traviswolverton/kerbal-controller/docs/decisions.md

# Design decisions so far

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

## Sourcing (decided)
- **Digi-Key is the primary source,** through its API (`docs/tools/parts.py`): one order, live price, stock and
  parametric data (panel cutouts, ratings). It also sells SparkFun, Adafruit and PJRC items, so the Teensy, fader, driver,
  nubbin and arcade button all moved there from Adafruit, PJRC and Amazon.
- **Amazon.com exceptions:** the SaiDian joysticks (not stocked), the MX switches and buzzers already owned, the DSA keycaps,
  the matched AITRIP guarded toggles and the Waveshare OLEDs (Digi-Key's 2.42" OLEDs cost $30 to $57 each). The encoder knobs
  moved to Digi-Key. The ballast steel is bought locally (the Amazon plate listings were dead links).
- **Reel trap:** many small parts default to reels with minimums of 4,000 to 5,000. The tool prefers cut tape or bulk.

## Key bank
- **4 x 6 MX keys**, each with a state-feedback pixel (action groups, SAS mode bank, custom
  action groups).
- **Layout B, "annunciator rows":** 19.05 mm column pitch, **36 mm row pitch**, with
  one pixel in its own clear space directly above each key.
  `docs/pitch-examples.png` is the earlier 28 mm drawing and is superseded for row pitch.
- **Revised after the mockup:** at 30 mm rows and a 12 degree tilt the pixel above each key is
  hidden behind the keycap in front of it (a keycap is about 13.5 mm tall). The seat-view renders in
  `docs/mockup/renders/` show it. The fix is a **steeper centre panel (28 degrees)** plus the
  **36 mm row pitch**; the two side modules stay at 12 degrees. Needs a real-world check with the test plate.
- **Switches (owned):** Josojoou 72-piece pack of **blue clicky, 3-pin, pre-lubricated** MX-style switches
  ([Amazon listing](https://www.amazon.com/dp/B0GC33V4HK)), bought 2026-10-10. 24 are used, so 48 spare.
  3-pin means no plastic side pegs, so a plain 14 mm square cutout should work. Clicky is loud;
  fine for a desk controller. Check snap-fit on the test plate (1.5 mm plate) and measure the
  housing below the plate (about 5 mm, plus pins) against the spacer depth.
- **Keycaps (chosen):** blank 1u **DSA profile** (about 7.6 mm tall, flat top), 24 pieces, from the
  [Mechkeeb 24 pcs DSA blank PBT listing](https://www.amazon.com/Mechkeeb-Profile-Switches-Keyboard-Replacement/dp/B0BWDQ3NKK)
  (B0BWDQ3NKK, Amazon.com). Colours still to pick: group by function (SAS / navigation, action groups,
  red for STAGE). Key labels go on the panel, not on the caps. The mockup's keycap proxy
  (18 mm wide, top at 13.5 mm above the plate) already assumes DSA. When they arrive, measure the real
  height with a switch fitted and re-check pixel visibility at 28 degrees.
- **Matrix:** hand-wired diode matrix (one 1N4148 per switch), 4 rows + 6 columns.
  Adafruit NeoKey boards were considered and dropped because they are hard to find.
- **Pixels:** BTF-LIGHTING WS2812B, 5050 on 10 mm round white PCBs (100 pcs, owned).
  Colour order **GRB**. Four solder pads per board (5V, GND, DIN, DOUT).
  Roughly 65 are planned (24 keys, 4 fuel bars of 8, 9 annunciator windows), so about 35 stay spare.
- **Data line:** 74AHCT125 level shifter, a 330-470 ohm series resistor near the first pixel,
  a large capacitor across the 5 V rail, and a separate 5 V supply of at least 3 A.
  Cap brightness in firmware.

## Joysticks (locked)
- **Two SaiDian JH-D400X-R4** 4-axis industrial joysticks, 10 kOhm potentiometers, 18.79 USD each
  ([Amazon listing](https://www.amazon.com/SaiDian-4-Axis-Joystick-Potentiometer-JH-D400X-R4/dp/B08CGYGMJL)).
  It is the part most KSP controller builds use.
- **Mapping:** right stick = pitch / yaw, twist = roll (Simpit rotation).
  Left stick = translation X / Y, twist = Z (Simpit translation). No separate rockers needed.
- **Grip buttons (decided):** the thumb button on each stick.
  - **Right stick (rotation): SAS toggle.** SAS is mostly about rotation, and the SAS key's pixel still shows the real state.
  - **Left stick (translation): hold for fine control.** While held, firmware scales that stick's X, Y and twist to about 25%
    (a tunable factor), then returns to full. It is done in firmware, so it does not depend on the game. Useful for docking.
    The game's own latching precision mode stays on the PRECISION button of the switch panel.
  - Both are direct Teensy inputs (pins 5 and 9), not on the expander, so a hold responds immediately.
- **Electrical:** passive potentiometers, so power them from the Teensy's **3.3 V**, not 5 V,
  to stay inside the ADC range. Listings give +/-20 % resistance tolerance and +/-1 %
  linearity, so calibrate the centre point and ranges in firmware.
- **Solder quickly:** the listings warn that heat can burn the part.
- **Dimensions** from the seller's side-view drawing (`docs/reference/jh-d400x-r4-side-view.png`),
  my reading of it:
  - Tilt: +/-25 degrees each way. Sealed (boot) design.
  - Grip: 35 mm diameter, 42 mm tall, with the Z (twist) potentiometer inside it.
  - Fourth "axis": a **momentary button switch on top of the grip**, not an analog axis.
    Free for something like an RCS toggle or SAS hold.
  - Overall height 84 mm to the top of the grip, plus 10.5 mm for the button = 94.5 mm.
  - Body below the mounting plate: 25.5 mm deep. That leaves about 58.5 mm above the plate
    to the top of the grip (about 69 mm to the top of the button).
  - Body width 40.4 mm, 49.6 mm including the Y potentiometer bump on one side.
  - X and Y potentiometers sit on the body (Y on the side that adds 9.2 mm).
- **Still not known:** the mounting flange outline, mounting hole spacing and hole diameter
  (the drawing is a side view and does not show them) and the cutout depth in the other
  direction. **Measure the units when they arrive** before drawing the stick panels, or find a top-view drawing.
- **Clearance estimate:** at full +/-25 degree tilt the grip edge sweeps roughly 35-40 mm from
  the stick axis (estimated from the drawing scale). Keep keys and other controls at least that far
  from each stick, with margin.

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

## Switch panel and annunciator (proposed)
- **Switch panel (left strip):** all inputs that are not wired to a stick or encoder go on one panel and one
  chip, an MCP23017 I2C expander sitting right behind it: ABORT (guarded toggle), a key switch that arms STAGE, a guarded ENGAGE / DISENGAGE toggle, a big STAGE
  button, throttle FULL and CUT, MAP, focus previous and next, quicksave, quickload, precision, pause, UI hide,
  and three spares. That is 16 inputs, listed in `pin-map.md`. Only SDA, SCL, the interrupt and 3V3 cross the
  cable to the Teensy.
- **Why:** the Teensy has no spare header pins, so extra buttons need an expander. A single panel keeps its
  wiring local and frees the toggle pins. This is also the part of the reference build (Altitude Workshops) we
  were missing: its guarded LOCK/STAGE block, throttle FULL button and utility buttons.
- **Buttons:** 13 small ones are the MX switches already owned, with blank DSA caps. A second pack of 24 caps is
  needed. STAGE moves off the key matrix to the big button, so its matrix slot becomes AG9.
- **Game side:** MAP, quicksave and the rest are key presses through Simpit's keyboard emulator (Windows only).
  FULL and CUT drive the throttle, and the motorised fader follows through Simpit's throttle command message.
- **Annunciator (right strip):** 3 x 3 windows, one pixel each: low fuel, low power, overheat, low altitude,
  stable orbit, atmosphere, chute safe, link, and CONTROLS (lit while engaged). Most of these come straight from Simpit messages
  (resources, temperature limit, atmosphere conditions, altitude, orbit, flight status). Chute-safe would be derived
  from altitude and airspeed. **High G was dropped: Simpit has no G-force message.**
- **Master power switch (middle strip, guarded):** in series with the 5 V rail. It cuts the pixels and the fader driver
  but leaves the Teensy and expander powered over USB. It is a third guarded toggle from the AITRIP pack, so a bump cannot
  kill the lights.
- **Layout effect:** the right strip's freed corner holds the annunciator and the middle strip gets the master switch. The
  strips are now 245 mm wide (see the keyboard decision below).
- **STAGE key (decided):** a key switch arms STAGE. The big STAGE button only fires while the key is on, which
  replaces the second guarded toggle. The key position is an expander input, so the firmware does the interlock.
- **RESET: skipped (decided).** Recovery from a hang is replugging the USB cable.
- **ENGAGE / DISENGAGE (decided):** a guarded toggle on the switch panel, modelled on the reference build's toggle by the
  throttle. Engaged, the sticks and throttle send input; disengaged, the firmware sends zero rotation and translation
  (which leaves SAS and the game in control) and stops sending throttle, so a bump or a leaning arm does nothing.
  The annunciator's ninth window, CONTROLS, lights while engaged. Check how Simpit hands the throttle back: its
  changelog mentions throttle authority being released.
- **Skipped, decided:** the reference's two arrow buttons beside its attitude stick. Our two sticks and the
  camera encoder cover that job; revisit only if you find you want attitude trim.
- **Parts picked (all Digi-Key):**
  - STAGE key switch: E-Switch KO133A801 (EG5876-ND, $7.07), 2-position SPST, **12 mm cutout**, key removable in
    position 1 only. Confirm in the datasheet that position 1 is OFF.
  - Big STAGE button: Adafruit 3489 arcade button (1528-2316-ND, $2.50), **30 mm cutout**, red 5 V LED, 2.8 mm quick-connect.
    The LED is open: always on, or driven later.
  - Master power switch: now a guarded AITRIP toggle (see below), replacing the E-Switch ST141D00 that was picked first.
  - Expander: MCP23017-E/SP (DIP-28, $1.69) with a socket, hand-wired on perfboard behind the panel instead of a breakout
    board. A0-A2 tied to GND (address 0x20), RESET through 10 k to 3V3, 0.1 uF across its supply.
- **Open:** the expander's interrupt behaviour is untested, and the Digi-Key key switch's key position needs confirming.

## Inter-module links (proposed, five-piece layout)
- **Approach:** direct wiring from the Teensy in the middle strip piece to each of the four outer pieces
  (two wings, left and right strip) through one **DB25 D-sub** each. One USB cable, no extra boards.
  Satellite microcontrollers with a 4-wire link would need fewer wires but add firmware and a second USB
  or serial path; revisit only if the cable count becomes a problem.
- **Conductors per port:** left wing 19, right wing 14, left strip 21, right strip 16, all of 25. Full
  pinouts and the Teensy pin table are in `pin-map.md`.
- **Pixels:** one chain of 65 on a single data pin: left strip (12), fuel bars in the middle (32), right strip
  (12 key pixels and 9 annunciator pixels). A break in the chain darkens everything after it.
- **Keys:** one 4 x 6 matrix. The left strip carries rows 0-1, the right strip rows 2-3, both carry all six
  column lines.
- **Parts (Digi-Key):** four **female** DB25 panel jacks on the middle piece (ITT Cannon ZDB25S) and one **male** jack
  on each outer piece (ZDB25P), joined by four straight-through shielded female-to-male cables, 1 m (Phoenix Contact
  1656291), listed in `parts-list.md`. The cables fit only one way round. The jacks mount from inside, with the flange
  against the inner wall and the body standing 11 mm proud. The wing jack is on the wing's outer end wall; the two outer
  strips and the middle strip carry theirs on the back wall, so every cable runs outside, behind the console (about 0.6 m of
  path for a wing cable). They are 1 m for all four to keep one part number; coil the slack.
  Keep analog runs short and put 0.1 uF on each wiper.
- **Swapped-cable rule:** all four ports use the same connector, so a cable in the wrong port must be
  harmless. Ground and 5 V sit on the same pins everywhere, and everything the Teensy drives (rows, pixel
  data, fader PWM) is on pins 15-23, which any module not using them leaves open. A script check of all 16
  module and port pairs found no conflict.
- **DB25 cutout (from the ITT Cannon ZD datasheet, rear mount):** 42.52 x 11.40 mm, with two 3.05 mm mounting holes
  47.04 mm apart (modelled 3.2 mm). The flange is 53.09 mm wide.
- **DC jack and fuse holder cutouts (from the datasheets, read 2026-10-20):** the Tensility 54-00151 needs a 10.9 mm hole with
  two flats 9.8 mm apart (panel 1.5 to 4.5 mm); the Wurth fuse holder needs a 13 mm hole with a 1.8 mm key out to 14 mm
  (panel 0.8 to 2.8 mm). Both sit in the middle strip's back wall (2.4 mm), so the thickness limits are met. Datasheet values,
  not yet checked on the parts.
- **Provisional cutout (orange in the mockup, size NOT verified):** the USB micro-B extension (15 x 8 mm slot with two 2.5 mm
  holes). SparkFun's drawing gives only the 26 mm body length, no panel cutout, so measure the part.
- **Open:** cable management behind the console, and the USB extension's cutout.

## 5 V power (chosen, not yet ordered)
- **Supply:** Mean Well GST25A05-P1J (Digi-Key 1866-2087-ND, $14.30): 5 V, 4 A max, 20 W, positive centre, 2.1 x 5.5 mm plug,
  1 m lead, cULus approved. It has an IEC C14 inlet, so a mains cord is a separate part (Tensility 11-00022, NEMA 5-15 to
  C13, $4.37). This replaces the Adafruit 1466.
- **Panel connector:** Tensility 54-00151 (Digi-Key 839-54-00151-ND, $4.81): 5.5 x 2.1 mm panel jack, 7.5 A, solder cup,
  rear nut. **Its panel cutout is not verified** (the datasheet is an image), so measure the jack or read the drawing
  before cutting. This replaces the Tugermoola kit from Amazon.
  - Wire from the solder cups: the centre pin is +. Check polarity with a meter before connecting anything.
  - Keep the jack close to the fuse and 5 V rail, or extend the wires.
- **Budget:** pixels are 65 x 60 mA = 3.9 A worst case (all white, which firmware must never allow); fader motor is unknown at 5 V, measure
  it. Cap total pixel draw in firmware so real use stays well under 4 A. The usual guidance is to keep
  the rail above 4.5 V at full load and to leave 20-25 % headroom.
- **Wiring plan:**
  - The Teensy is powered **only from USB**. The external 5 V feeds the pixels, the level shifter and the
    fader driver, with ground shared with the Teensy. Do not tie the 5 V rail to the Teensy's VIN.
  - Put a fuse sized just above the capped load on the 5 V rail, and the 1000 uF capacitor where the rail
    enters the pixel run.
  - The 2.42" OLED modules accept 3.3-5 V, so power them from the 5 V rail to keep load off the Teensy's
    3.3 V regulator. Confirm the module's logic level first.
  - The pixels are spread over the three strip pieces (12, 32, 21). Each outer strip takes 5 V over its DB25 cable; one power input in the middle strip feeds everything.

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

## Mockup (v0 proposal)
See `docs/mockup/README.md`. Three modules of 220 / 240 / 220 mm width, 245 mm deep, tilted
12 / 28 / 12 degrees. All positions are a first proposal to react to.

## Open items
- Measure the real pixel board (diameter and height) with calipers.
- Print the test plate (`cad/test_plate.scad`) and settle the MX cutout tolerance and
  diffuser thickness.
- Measure the joysticks on arrival (mounting flange, hole spacing and diameter, cutout).
- Whether to include the round attitude TFT.
- Column pitch: 19.05 mm for now, 22-25 mm is an option for finger room.
- Check the 28 degree centre tilt feels right at your desk (prop the test plate at that angle).
- Firmware: key assignment map, Simpit channel list, serpentine pixel mapping.
