traviswolverton/kerbal-controller/docs/pin-map.md

# Pin map and cabling (draft, five-piece layout)

Teensy 4.1 pin assignment, the cabling between the five pieces, and the four DB25 pinouts. Matches
`cad/console_mockup_v1.scad`. **This file is generated by `docs/tools/gen_pinout.py`, the same script that draws
the diagrams in [wiring.md](wiring.md) (renders on GitHub) and [pinout.html](pinout.html) (for a browser).
Edit the data in the script, not this file.** Draft: nothing is built yet. Context is in `decisions.md` and
`parts-list.md`.

## Topology

```
                         LEFT WING                          RIGHT WING
                         stick, fader, enc                  stick, 2 enc
                              |  DB25 (19)                       |  DB25 (14)
                              |                                  |
   STRIP LEFT  --DB25 (21)--  STRIP MIDDLE  --DB25 (16)--  STRIP RIGHT
   12 nav keys                Teensy, 2 OLEDs, 32 fuel         12 action-group keys
   switch panel + expander    pixels, buzzer, master switch,   annunciator
   12 pixels                  power jack                       21 pixels
                              (5 V in, fuse, 1000 uF)
```

- The **middle strip** holds the Teensy, the 5 V input, the 74AHCT125 and the OLEDs and buzzer. It has four DB25
  jacks, one per outer piece.
- The **left strip** carries a **switch panel**: 16 inputs on one MCP23017 I2C expander that sits right behind
  the panel. The inputs wire locally, so only SDA, SCL, the interrupt and 3V3 cross the cable. The inputs are
  the guarded ABORT toggle, a key switch that arms STAGE, a big STAGE button, throttle FULL and CUT, MAP, focus
  previous and next, quicksave, quickload, precision, pause, UI hide, a guarded ENGAGE / DISENGAGE toggle and two spares.
- The **right strip** carries a 3 x 3 **annunciator**: one pixel behind each of nine windows.
- The two **wings** sit in front of the outer strip pieces, so their jacks are on the wings' outer end walls. The
  strip pieces and the middle strip have their jacks on their back walls. Every cable runs outside, behind the console
  (the middle strip has the four female jacks in two rows). About 0.6 m of path for a wing cable, so a 1 m cable has slack.
- **Pixels are one chain of 65** on a single data pin: left strip (12 key pixels), then the 32 fuel bars in the
  middle, then the right strip (12 key pixels and 9 annunciator pixels). The data goes out to the left strip on
  pin 17, comes back on pin 18, runs through the fuel bars, and leaves for the right strip on pin 17 of that
  port. Put the 330-470 ohm series resistor at the first pixel (in the left strip). If a strip cable is
  unplugged, every pixel after it goes dark.
- **Keys are one 4 x 6 matrix** split across the strips: the left strip carries rows 0-1 and the right
  strip rows 2-3. Both carry all six column lines, which are paralleled in the middle piece. STAGE is no longer
  a matrix key: its slot is AG9.

## Constraints that shaped it

- All 3.3 V, none of the pins are 5 V tolerant. Analog inputs must stay at or below 3.3 V.
- Only header pins 0-41 are used. Pins 42 and up are bottom pads.
- **Pin 1** is the pixel data output: Serial1 TX, supported by the WS2812Serial library (non-blocking, DMA).
  It goes to the 74AHCT125 level shifter.
- **Pins 2 and 3** are the fader PWM pair: both are on timer FlexPWM4.2, so they share one frequency
  (default 4.482 kHz, changeable with `analogWriteFrequency`).
- **Pins 18 and 19** are the Teensy's I2C pins (SDA, SCL), used for the switch-panel expander. Fit 4.7 kΩ
  pull-ups to 3V3 at the Teensy end.
- **Pin 13** has the on-board LED and is the SPI clock for the OLEDs. **Pin 12** is MISO on SPI0 but is a
  plain GPIO here (OLED DC), because the OLEDs are write-only.
- Analog inputs are pins 14-27 and 38-41; the seven used are 14-17 and 20-22.
- The 3.3 V regulator is good for about 250 mA external. The pots and the expander draw almost nothing.
- The matrix is read by driving a row low and reading the columns with pull-ups. **Leave the other rows
  as inputs (high impedance), never driven high**, so a stray short cannot fight a driven pin.

## Teensy 4.1 assignment

| Pin | Signal | Direction | Piece |
|---|---|---|---|
| 0 | OLED_RES | out | middle strip |
| 1 | PIXEL_DATA | out | middle strip |
| 2 | FADER_PWM_A | out | left wing |
| 3 | FADER_PWM_B | out | left wing |
| 4 | FADER_TOUCH | in (FastTouch) | left wing |
| 5 | L_STICK_BTN | in, pull-up | left wing |
| 6 | L_ENC_A | in, pull-up | left wing |
| 7 | L_ENC_B | in, pull-up | left wing |
| 8 | L_ENC_SW | in, pull-up | left wing |
| 9 | R_STICK_BTN | in, pull-up | right wing |
| 10 | OLED_CS1 | out | middle strip |
| 11 | OLED_MOSI | out | middle strip |
| 12 | OLED_DC | out | middle strip |
| 13 | OLED_SCK | out | middle strip |
| 14 (A0) | L_STICK_X | analog | left wing |
| 15 (A1) | L_STICK_Y | analog | left wing |
| 16 (A2) | L_STICK_Z | analog | left wing |
| 17 (A3) | FADER_WIPER | analog | left wing |
| 18 | EXP_SDA | I2C, 4.7 kΩ pull-up to 3V3 | left strip, switch panel expander |
| 19 | EXP_SCL | I2C, 4.7 kΩ pull-up to 3V3 | left strip, switch panel expander |
| 20 (A6) | R_STICK_X | analog | right wing |
| 21 (A7) | R_STICK_Y | analog | right wing |
| 22 (A8) | R_STICK_Z | analog | right wing |
| 23 | R_CAM_SW | in, pull-up | right wing |
| 24 | OLED_CS2 | out | middle strip |
| 25 | BUZZER | out | middle strip |
| 26 | R_CAM_A | in, pull-up | right wing |
| 27 | R_CAM_B | in, pull-up | right wing |
| 28 | ROW0 | out | left strip |
| 29 | ROW1 | out | left strip |
| 30 | ROW2 | out | right strip |
| 31 | ROW3 | out | right strip |
| 32 | COL0 | in, pull-up | both strips |
| 33 | COL1 | in, pull-up | both strips |
| 34 | COL2 | in, pull-up | both strips |
| 35 | COL3 | in, pull-up | both strips |
| 36 | COL4 | in, pull-up | both strips |
| 37 | COL5 | in, pull-up | both strips |
| 38 | R_PAGE_A | in, pull-up | right wing |
| 39 | R_PAGE_B | in, pull-up | right wing |
| 40 | R_PAGE_SW | in, pull-up | right wing |
| 41 | EXP_INT | in, pull-up | left strip, switch panel expander |

All 42 header pins are used. Any further switch goes on the expander (16 inputs, all assigned including 3
spares) or a second MCP23017 at another address.

## Switch-panel expander

MCP23017-E/SP (DIP-28), hand-wired on perfboard behind the panel. Address pins A0-A2 tied to GND (address 0x20), RESET
through 10 kΩ to 3V3, 0.1 uF across its supply. Mirror both interrupt ports onto INTA. Internal pull-ups on, the other
leg of every switch to GND.

| Expander pin | Input |
|---|---|
| PA0 | ABORT (guarded toggle) |
| PA1 | STAGE KEY (key switch: STAGE only works while it is on) |
| PA2 | STAGE (big button) |
| PA3 | THROTTLE FULL |
| PA4 | THROTTLE CUT |
| PA5 | MAP |
| PA6 | FOCUS PREVIOUS |
| PA7 | FOCUS NEXT |
| PB0 | QUICKSAVE |
| PB1 | QUICKLOAD |
| PB2 | PRECISION |
| PB3 | PAUSE |
| PB4 | UI HIDE |
| PB5 | ENGAGE / DISENGAGE (guarded toggle: sticks and throttle live or ignored) |
| PB6-PB7 | spare |

MAP, quicksave, quickload and the rest go to the game as key presses through Simpit's keyboard emulator
(Windows only). FULL and CUT drive the throttle, and the motorised fader follows through the throttle command
Simpit sends back. ENGAGE / DISENGAGE is a controls-live interlock: disengaged, the firmware sends zero rotation and
translation (so SAS and the game keep control) and stops sending throttle; the annunciator's CONTROLS window lights
while engaged. Check how Simpit hands the throttle back (its changelog mentions throttle authority being released).

## DB25 pinouts

Standard DB25 numbering, pins 1-13 on the wide row and 14-25 on the other. The outer pieces have male jacks and the
middle strip female jacks, joined by female-to-male cables, but all four middle jacks are alike, so a cable can still go
in the wrong middle port. The pins are laid out so that is **harmless**:

- Ground is on pins 1, 7, 13, 24, 25 on every port.
- 3.3 V (pin 2) is provided on the two wing ports and the left-strip port. 5 V (pins 20, 21) is provided on the
  left-wing and both strip ports.
- Everything the Teensy **drives** sits on pins 15-23 only: matrix rows and pixel data on pins 15-17 of the
  strip ports, fader PWM on pins 22 and 23 of the left-wing port. Pins that are not used by a module are left
  open, never wired to something else. So a module never connects a switch, a wiper or a ground to a pin the
  Teensy drives.
- SDA and SCL (pins 10 and 11 of the left-strip port) are weak pulled-up open-drain lines, so a switch pulling
  them low on another cable only upsets the bus, it cannot damage anything.
- A script check (all 16 combinations of module and port) found no conflict, only wrong behaviour.

| Pin | Left Wing | Right Wing | Strip Left | Strip Right |
|---|---|---|---|---|
| 1 | GND | GND | GND | GND |
| 2 | 3V3 | 3V3 | 3V3 | open |
| 3 | L_STICK_X | R_STICK_X | COL0 | COL0 |
| 4 | L_STICK_Y | R_STICK_Y | COL1 | COL1 |
| 5 | L_STICK_Z | R_STICK_Z | COL2 | COL2 |
| 6 | FADER_WIPER | open | COL3 | COL3 |
| 7 | GND | GND | GND | GND |
| 8 | L_STICK_BTN | R_STICK_BTN | COL4 | COL4 |
| 9 | L_ENC_A | R_CAM_A | COL5 | COL5 |
| 10 | L_ENC_B | R_CAM_B | EXP_SDA | open |
| 11 | L_ENC_SW | R_CAM_SW | EXP_SCL | open |
| 12 | FADER_TOUCH | R_PAGE_A | EXP_INT | open |
| 13 | GND | GND | GND | GND |
| 14 | open | R_PAGE_B | open | open |
| 15 | open | open | ROW0 | ROW2 |
| 16 | open | open | ROW1 | ROW3 |
| 17 | open | open | PIXEL_IN | PIXEL_IN |
| 18 | open | open | PIXEL_OUT | open |
| 19 | open | R_PAGE_SW | open | open |
| 20 | 5V | open | 5V | 5V |
| 21 | 5V | open | 5V | 5V |
| 22 | FADER_PWM_A | open | open | open |
| 23 | FADER_PWM_B | open | open | open |
| 24 | GND | open | GND | GND |
| 25 | GND | open | GND | GND |
| **Conductors** | 19 | 14 | 21 | 16 |

Notes:
- Analog lines (stick X, Y, twist and the fader wiper) sit between ground pins so they are not neighbours of
  digital lines. Put a 0.1 uF capacitor from each wiper to ground at the Teensy end.
- **Cable shield:** ground it to the connector shell at the middle end only, to avoid a ground loop.
- **Pixel power:** each strip piece takes 5 V on pins 20 and 21 (two conductors, up to about 1.3 A worst case
  for 21 pixels on the right strip). The 32 fuel-bar pixels are in the middle piece and are fed straight from the
  5 V rail. A 100 uF capacitor across 5 V in each strip piece is optional.
- **Left wing:** the L9110H fader driver is in the wing next to the motor, so only the two PWM lines and 5 V
  cross the cable. Pots take 3V3 on pin 2, never 5 V.
- **Cables:** a wing cable runs from the wing's end wall round the back to the middle strip, about 0.6 m of path. The
  strip-to-middle cables are about 0.3 m. All four are 1 m, so coil the slack. Keep analog and I2C runs short.

## Open

- **Cable management** behind the console (clips or a cable channel, strain relief): not designed.
- **I2C over the cable:** about 30 cm at 400 kHz with 4.7 kΩ pull-ups should be fine; not tested.
- **OLED modules:** confirm their logic level and supply. They accept 3.3-5 V, so power them from 5 V, but
  check the SPI lines are 3.3 V safe in that case. Not verified.
- **Pixel chain through cables:** a break in the chain (an unplugged strip cable) kills the pixels after it.
  Fine for a build, worth knowing when debugging.
- **HIGH G** annunciator window dropped: Simpit has no G-force message.
- **Confirm the physical Teensy pin positions** before wiring: this map uses pin numbers only.
- **DB25 jack cutouts** are not in the mockup yet.
