traviswolverton/kerbal-controller/docs/mockup/templates/center-panel-template-1to1.pdf

## This site can’t be reached

The webpage at file://../docs/mockup/templates/center.html might be temporarily down or it may have moved permanently to a new web address.

ERR_INVALID_URL
