traviswolverton/kerbal-controller/docs/img/seat-view.png

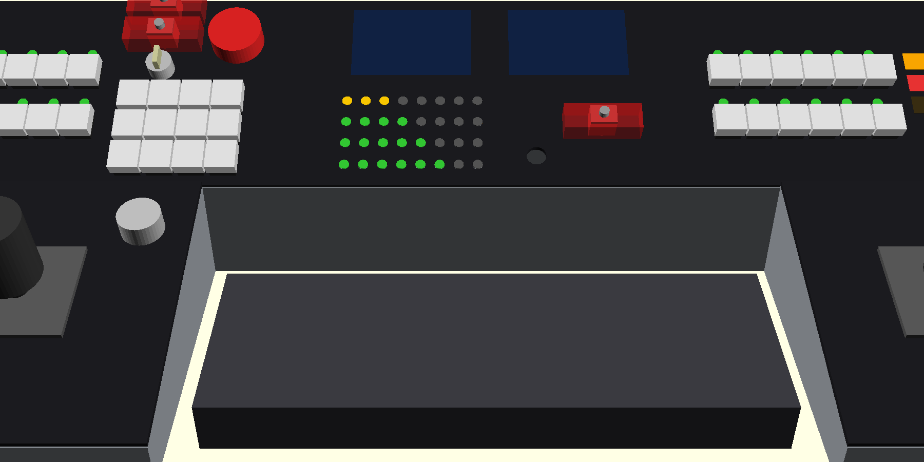
docs/img/seat-view.png
