traviswolverton/kerbal-controller/docs/mockup/renders/console-front.png

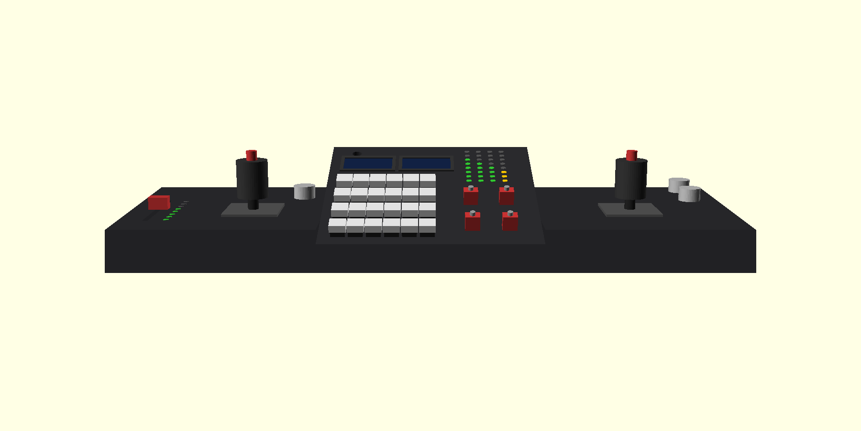
docs/mockup/renders/console-front.png
