traviswolverton/kerbal-controller/docs/mockup/renders/console-iso.png

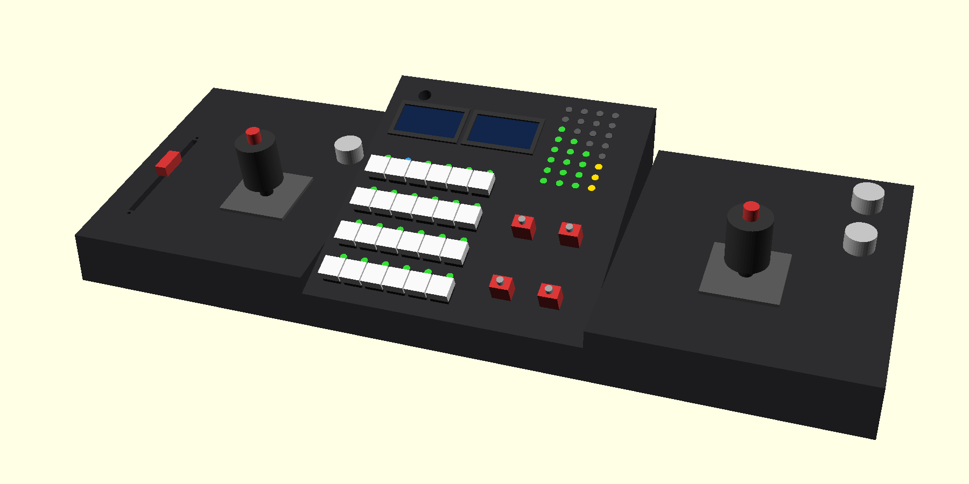
docs/mockup/renders/console-iso.png
