traviswolverton/kerbal-controller/docs/mockup/renders/console-side-center.png

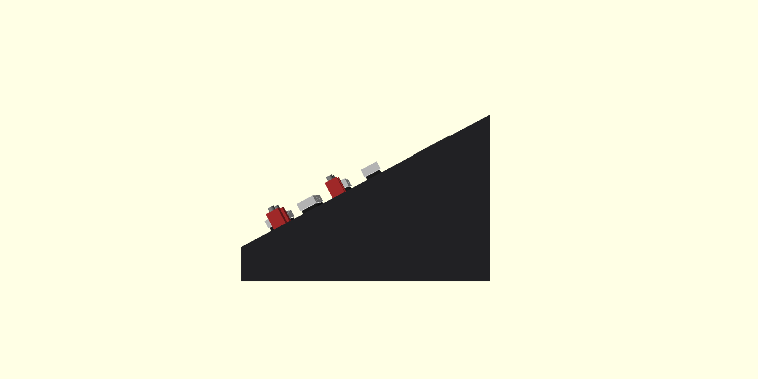
docs/mockup/renders/console-side-center.png
