traviswolverton/kerbal-controller/docs/mockup/renders/console-top.png

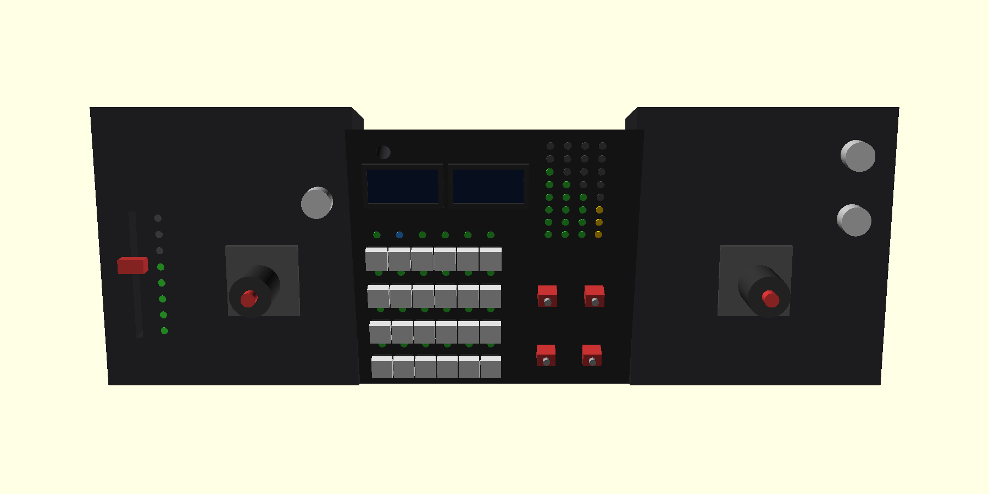
docs/mockup/renders/console-top.png
