traviswolverton/kerbal-controller/docs/mockup/renders/seat-view-center-tilt12.png

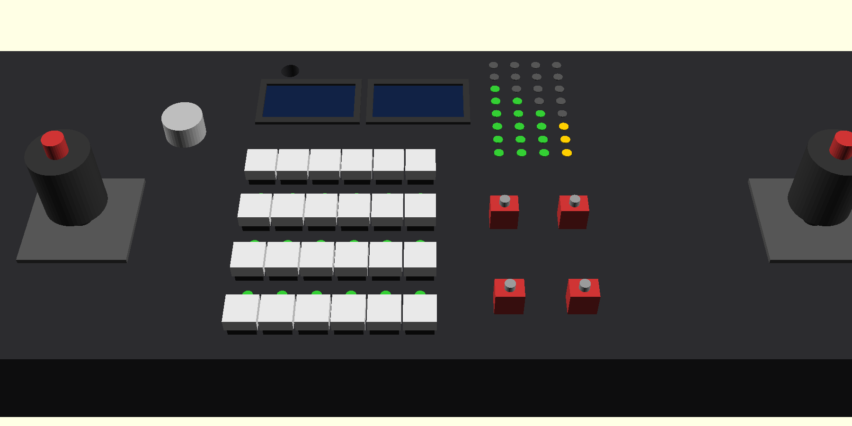
docs/mockup/renders/seat-view-center-tilt12.png
