traviswolverton/kerbal-controller/docs/mockup/renders/seat-view.png

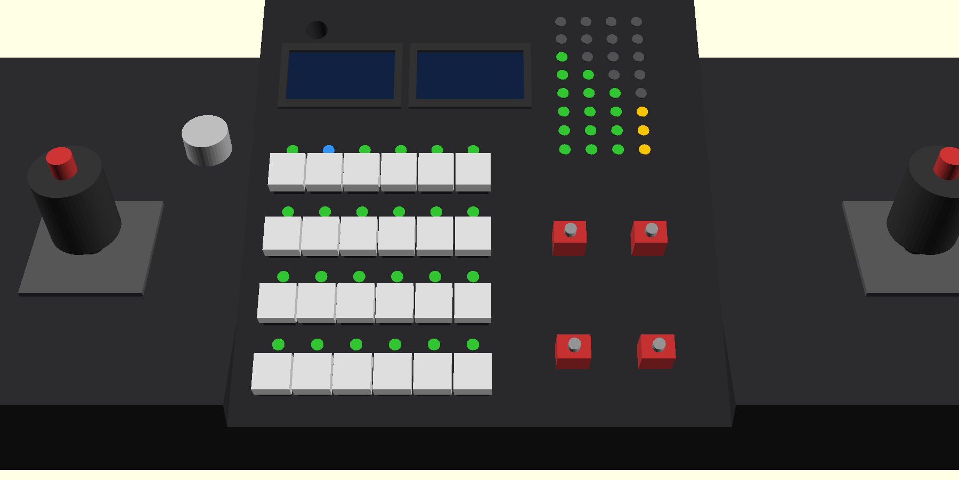
docs/mockup/renders/seat-view.png
