traviswolverton/kerbal-controller/docs/mockup/renders/v1-strip-cutaway.png

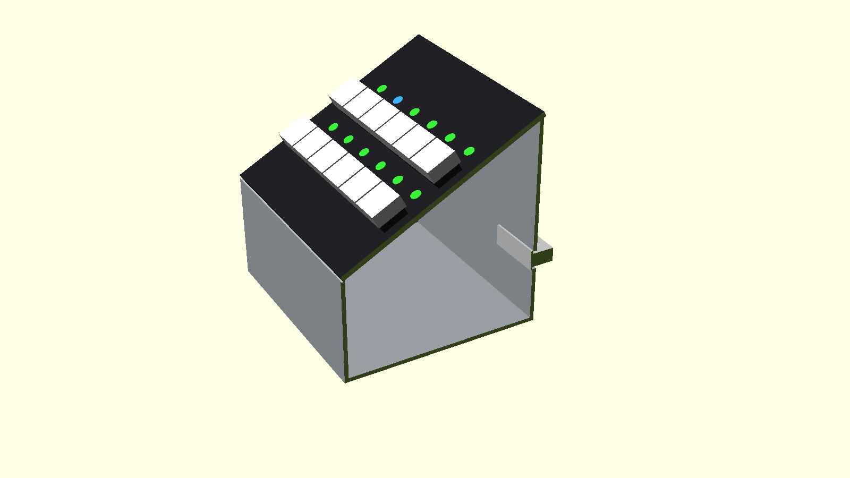
docs/mockup/renders/v1-strip-cutaway.png
