traviswolverton/kerbal-controller/docs/mockup/v1/renders/v1-iso.png

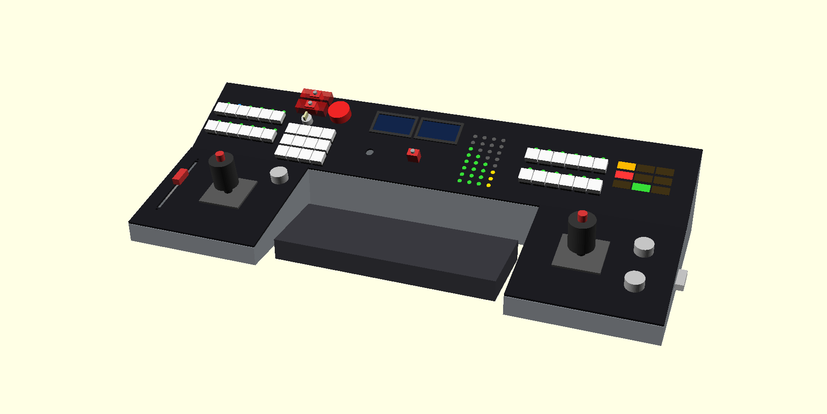
docs/mockup/v1/renders/v1-iso.png
