traviswolverton/kerbal-controller/docs/mockup/v1/renders/v1-rear.png

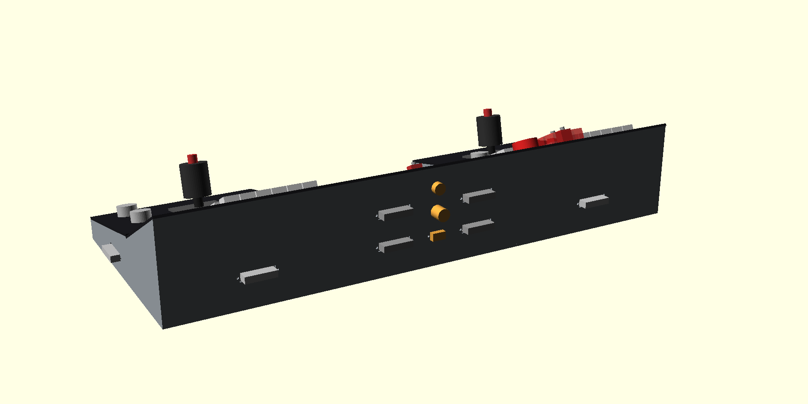
docs/mockup/v1/renders/v1-rear.png
