traviswolverton/kerbal-controller/docs/mockup/v1/renders/v1-seat-view.png

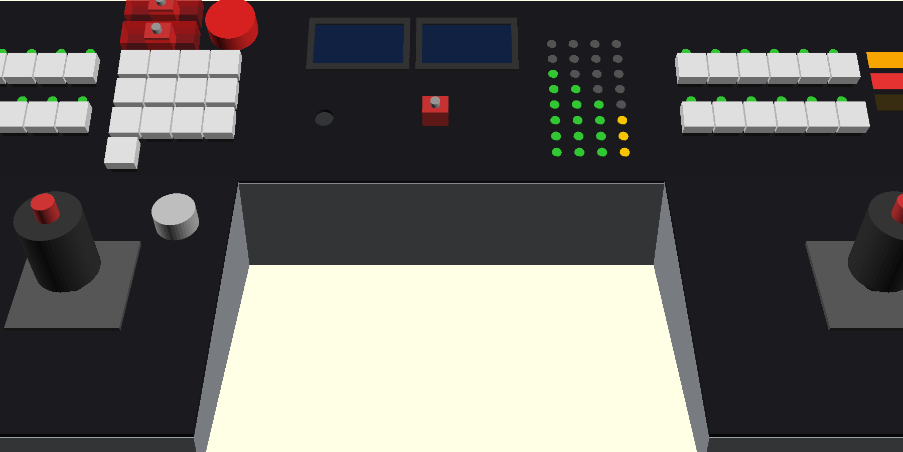
docs/mockup/v1/renders/v1-seat-view.png
