traviswolverton/kerbal-controller/docs/mockup/v1/renders/v1-top.png

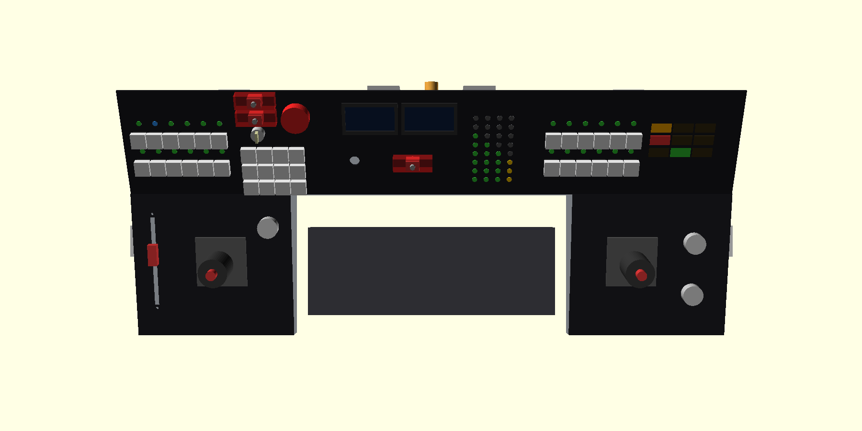
docs/mockup/v1/renders/v1-top.png
