traviswolverton/kerbal-controller/docs/pitch-examples.png

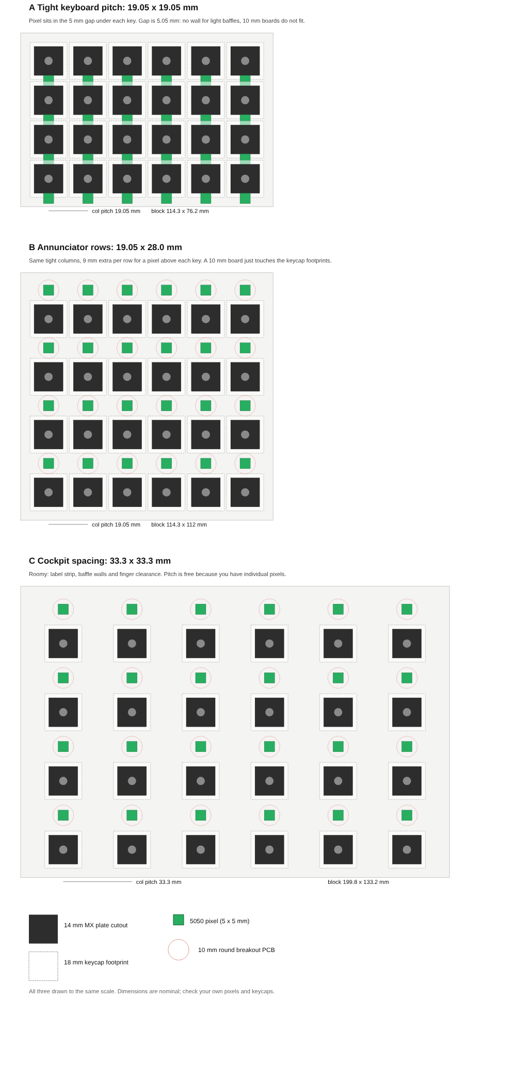
docs/pitch-examples.png
