traviswolverton/kerbal-controller/docs/reference/jh-d400x-r4-side-view.png

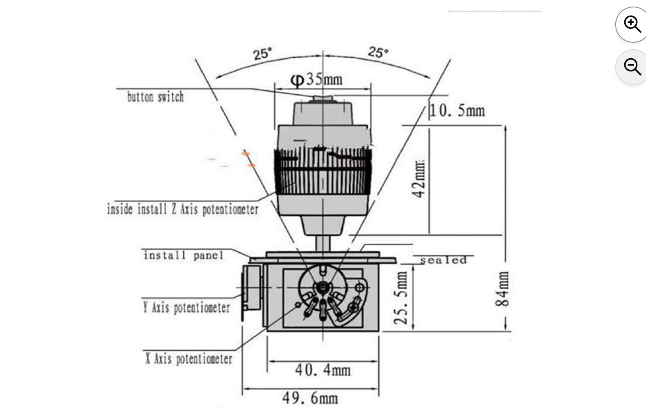
docs/reference/jh-d400x-r4-side-view.png
