traviswolverton/kerbal-controller/hardware/sourcing/budget.md

# Budget

Combined order totals, USD, **before shipping and tax**. Digi-Key and Mouser prices come from the shortlist (`hardware/sourcing/parts-shortlist.json`, last checked 2026-10-20); Amazon prices are kept by hand in `hardware/sourcing/amazon-items.json` because Amazon has no price API. Regenerate with `python3 tools/parts.py budget --md` (add `--live` to re-check the distributor prices first).

| | Lines | Amount |
|---|---|---|
| Digi-Key and Mouser | 36 | $370.39 |
| Amazon.com, priced | 4 | $117.53 |
| Amazon.com, **no price yet** | 0 | not counted |
| **Total so far** | | **$487.92** |

## Amazon.com to buy

| Item | ASIN | Qty | Unit | Extended | Note |
|---|---|---|---|---|---|
| JH-D400X-R4 joystick (SaiDian) | B08CGYGMJL | 2 | $18.79 | $37.58 | Price from the listing when chosen. |
| DSA blank keycaps, 1u, 24-pack (Mechkeeb) | B0BWDQ3NKK | 2 | $8.99 | $17.98 | Two packs for 37 caps. Colours to pick. |
| Guarded toggle switches with covers, 6-pack (AITRIP) | B0CL4GNMJX | 1 | $9.99 | $9.99 | ABORT, ENGAGE / DISENGAGE and the master power switch. Check the photos show a bat-handle toggle. |
| Weight vest steel plates, 8-pack (Mavee, silver electroplated) | unknown | 2 | $25.99 | $51.98 | Ballast: 8 plates per wing (16 in all, 2 packs, about 3.2 kg); the pocket takes 12 per wing if a third pack is needed. Link: https://a.co/d/0axItt4q (short link, ASIN not resolved). 5.9 x 0.98 x 0.28 in, 0.44 lb each. |

## Already owned

Not in the total. Prices are the listing price seen, not necessarily what was paid.

| Item | ASIN | Qty | Listing price | Note |
|---|---|---|---|---|
| MX-style blue clicky switches, 72-pack (Josojoou) | B0GC33V4HK | 1 | $12.99 | Bought 2026-10-10. 37 used. |
| Passive buzzer module, 5-pack (DIYables) | B0DHGP95K4 | 1 | $6.99 | Ordered 2026-10-10. |
| WS2812B 10 mm pixel boards, 100 (BTF-LIGHTING) | unknown | 1 | unknown | 65 used. |

## Digi-Key and Mouser

See [parts-bom.md](parts-bom.md) for the per-line list with stock and flags.

| Role | Source | Part number | Qty | Unit | Extended |
|---|---|---|---|---|---|
| Teensy 4.1 (headers fitted) | digikey | [1568-20360-ND](https://www.digikey.com/en/products/detail/sparkfun-electronics/20360/16688096) | 1 | $33.60 | $33.60 |
| 5 V 4 A desktop adapter (Mean Well GST25A05-P1J) | digikey | [1866-2087-ND](https://www.digikey.com/en/products/detail/mean-well-usa-inc/GST25A05-P1J/7703645) | 1 | $14.30 | $14.30 |
| Mains cord NEMA 5-15 to IEC C13 for the adapter | digikey | [839-11-00022-ND](https://www.digikey.com/en/products/detail/tensility/11-00022/3900584) | 1 | $4.37 | $4.37 |
| Panel DC jack 5.5 x 2.1 mm | digikey | [839-54-00151-ND](https://www.digikey.com/en/products/detail/tensility/54-00151/9829987) | 1 | $4.81 | $4.81 |
| Panel fuse holder 5 x 20 mm | digikey | [732-952005000010000-ND](https://www.digikey.com/en/products/detail/w%C3%BCrth-elektronik/952005000010000/28172649) | 1 | $2.15 | $2.15 |
| 4 A fuse 5 x 20 mm (1 spare) | digikey | [F1724-ND](https://www.digikey.com/en/products/detail/littelfuse-inc/0217004-MXP/777547) | 2 | $0.57 | $1.14 |
| STAGE key switch (12 mm cutout) | digikey | [EG5876-ND](https://www.digikey.com/en/products/detail/e-switch/KO133A801/1804779) | 1 | $7.07 | $7.07 |
| Big STAGE button, 30 mm arcade, red LED | digikey | [1528-2316-ND](https://www.digikey.com/en/products/detail/adafruit-industries-llc/3489/7349495) | 1 | $2.50 | $2.50 |
| Motorised 100 mm fader (Adafruit 5466) | digikey | [1528-5466-ND](https://www.digikey.com/en/products/detail/adafruit-industries-llc/5466/16645060) | 1 | $24.95 | $24.95 |
| L9110H fader driver | digikey | [1528-4489-ND](https://www.digikey.com/en/products/detail/adafruit-industries-llc/4489/11594498) | 1 | $1.50 | $1.50 |
| Conductive nubbin for the fader | digikey | [1528-5741-ND](https://www.digikey.com/en/products/detail/adafruit-industries-llc/5741/20370638) | 1 | $6.19 | $6.19 |
| Rotary encoders (time warp, camera, page) | digikey | [PEC11R-4215F-S0024-ND](https://www.digikey.com/en/products/detail/bourns-inc/PEC11R-4215F-S0024/4499665) | 3 | $2.95 | $8.85 |
| I2C expander for the switch panel | digikey | [MCP23017-E/SP-ND](https://www.digikey.com/en/products/detail/microchip-technology/MCP23017-E-SP/894272) | 1 | $1.69 | $1.69 |
| DIP-28 socket for the expander | digikey | [1175-1490-ND](https://www.digikey.com/en/products/detail/cnc-tech/245-28-1-06/3441586) | 1 | $1.29 | $1.29 |
| 74AHCT125 level shifter, DIP | digikey | [296-4655-5-ND](https://www.digikey.com/en/products/detail/texas-instruments/SN74AHCT125N/375798) | 1 | $1.00 | $1.00 |
| DIP-14 socket for the level shifter | digikey | [1175-1487-ND](https://www.digikey.com/en/products/detail/cnc-tech/245-14-1-03/3441580) | 1 | $0.73 | $0.73 |
| Matrix diodes (24 plus spares) | digikey | [1N4148FS-ND](https://www.digikey.com/en/products/detail/onsemi/1N4148/458603) | 30 | $0.06 | $1.80 |
| 330 ohm pixel data resistor (1 spare) | digikey | [CF14JT330RCT-ND](https://www.digikey.com/en/products/detail/stackpole-electronics-inc/CF14JT330R/1741399) | 2 | $0.10 | $0.20 |
| 4.7 kohm I2C pull-ups (spares) | digikey | [CF14JT4K70CT-ND](https://www.digikey.com/en/products/detail/stackpole-electronics-inc/CF14JT4K70/1741428) | 3 | $0.10 | $0.30 |
| 10 kohm expander reset pull-up (spares) | digikey | [CF14JT10K0CT-ND](https://www.digikey.com/en/products/detail/stackpole-electronics-inc/CF14JT10K0/1741265) | 3 | $0.10 | $0.30 |
| 1000 uF 16 V rail capacitor (1 spare) | digikey | [1189-1147-ND](https://www.digikey.com/en/products/detail/rubycon/16ZLH1000MEFC10X16/3134105) | 2 | $0.71 | $1.42 |
| 47 uF 25 V fader driver capacitor (1 spare) | digikey | [732-8823-1-ND](https://www.digikey.com/en/products/detail/w%C3%BCrth-elektronik/860020472006/5727060) | 2 | $0.10 | $0.20 |
| 0.1 uF decoupling and wiper capacitors | digikey | [BC1101CT-ND](https://www.digikey.com/en/products/detail/vishay-beyschlag-draloric-bc-components/K104K15X7RF5TH5/286555) | 12 | $0.17 | $2.04 |
| DB25 female panel jack (middle strip) | digikey | [1003-ZDB25S-ND](https://www.digikey.com/en/products/detail/itt-cannon-llc/ZDB25S/21361496) | 4 | $3.99 | $15.96 |
| DB25 male panel jack (outer pieces) | digikey | [1003-ZDB25P-ND](https://www.digikey.com/en/products/detail/itt-cannon-llc/ZDB25P/21361449) | 4 | $3.42 | $13.68 |
| DB25 shielded cable, female to male, 1 m | digikey | [277-12299-ND](https://www.digikey.com/en/products/detail/phoenix-contact/1656291/4449846) | 4 | $15.70 | $62.80 |
| Panel USB micro-B extension for the Teensy | digikey | [1568-15464-ND](https://www.digikey.com/en/products/detail/sparkfun-electronics/15464/10440474) | 1 | $4.42 | $4.42 |
| Perfboard 94 x 63 mm (middle strip main board) | digikey | [1568-12070-ND](https://www.digikey.com/en/products/detail/sparkfun-electronics/12070/5230951) | 1 | $8.65 | $8.65 |
| Screw terminal 5.08 mm, 2 position | digikey | [ED2609-ND](https://www.digikey.com/en/products/detail/on-shore-technology-inc/OSTTC022162/614558) | 6 | $0.58 | $3.48 |
| Screw terminal 5.08 mm, 4 position | digikey | [ED2611-ND](https://www.digikey.com/en/products/detail/on-shore-technology-inc/OSTTC042162/614560) | 8 | $1.08 | $8.64 |
| Female header 24 position (Teensy sockets, spare) | digikey | [S7022-ND](https://www.digikey.com/en/products/detail/sullins-connector-solutions/PPTC241LFBN-RC/810162) | 3 | $1.34 | $4.02 |
| Hookup wire 22 AWG stranded, 10 colours x 25 ft | digikey | [1528-3175-ND](https://www.digikey.com/en/products/detail/adafruit-industries-llc/3175/6198258) | 1 | $32.29 | $32.29 |
| Hookup wire 22 AWG solid, 6 colours x 25 ft (matrix) | digikey | [1528-1743-ND](https://www.digikey.com/en/products/detail/adafruit-industries-llc/1311/6198255) | 1 | $15.95 | $15.95 |
| Encoder knobs, 25 mm D shaft (CLIFF KMK25) | digikey | [4654-FC7254-ND](https://www.digikey.com/en/products/detail/cliff-electronic-components-ltd/FC7254/21406846) | 3 | $4.90 | $14.70 |
| Perfboard 78 x 58 mm, pad per hole (expander, wing and bus boards) | digikey | [1738-1001-ND](https://www.digikey.com/en/products/detail/dfrobot/FIT0203/6588423) | 4 | $2.90 | $11.60 |
| 3.5in IPS TFT display 480x320 SPI (DFRobot DFR0669) | digikey | [1738-DFR0669-ND](https://www.digikey.com/en/products/detail/dfrobot/DFR0669/13280137) | 2 | $25.90 | $51.80 |

## Not counted at all

Solder and flux, cable clips and zip ties, M3 screws and standoffs, silicone feet, filament (2 to 3 kg), mains-side extras, the stick and encoder connectors, and shipping and tax.
