traviswolverton/kerbal-controller/cad/stl/test_plate_plate.stl

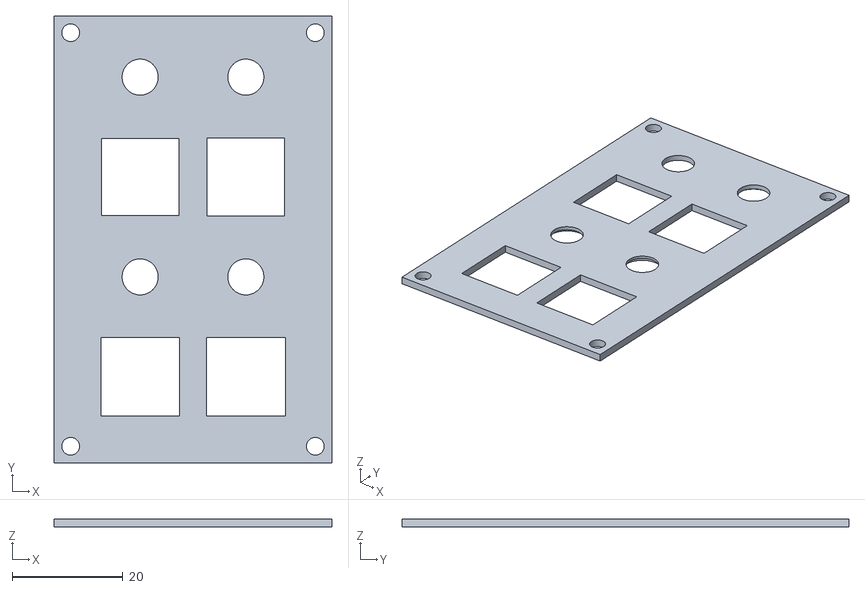
[picture p21: CAD file, 2026-10-19]
cad/stl/test_plate_plate.stl
50.1 x 80.5 x 1.50
