traviswolverton/kerbal-controller/hardware/cad/stl/test_plate_spacer.stl

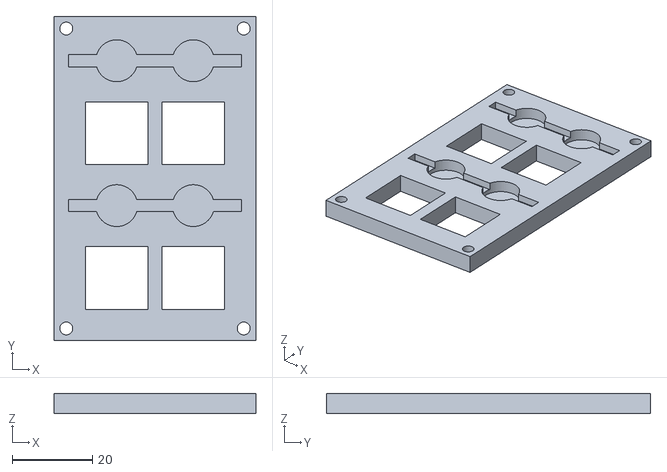
[picture p22: CAD file, 2026-10-20]
hardware/cad/stl/test_plate_spacer.stl
50.1 x 80.5 x 5.00
