traviswolverton/kerbal-controller/cad/stl/test_plate_spacer.stl

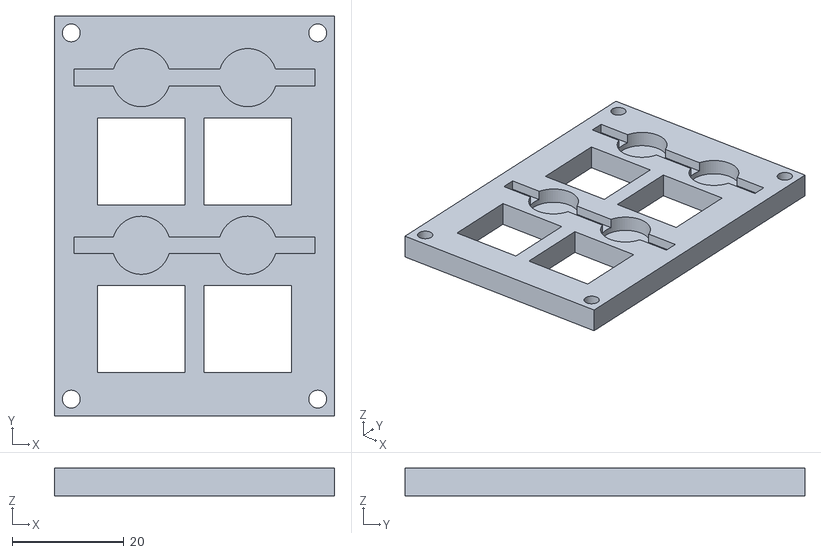
[picture p23: CAD file, 2026-10-19]
cad/stl/test_plate_spacer.stl
50.1 x 71.5 x 5.00
