traviswolverton/kerbal-controller/hardware/cad/stl/test_plate_diffusers.stl

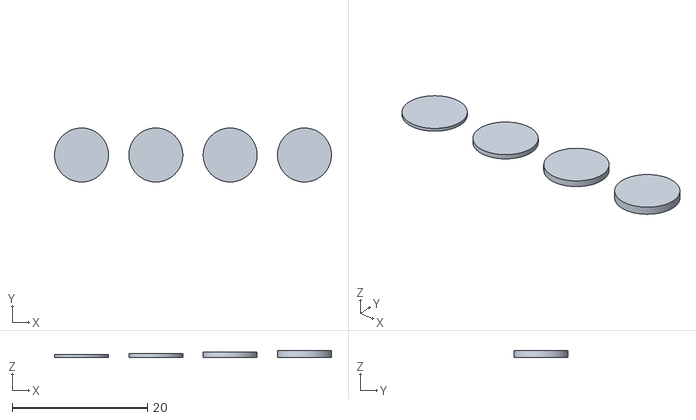
[picture p24: CAD file, 2026-10-20]
hardware/cad/stl/test_plate_diffusers.stl
41.0 x 8.00 x 1.00
