traviswolverton/kerbal-controller/docs/reference/digikey_dxf/SOLDERBREAD02_DXF_Outline_in_MilliMeters.dxf

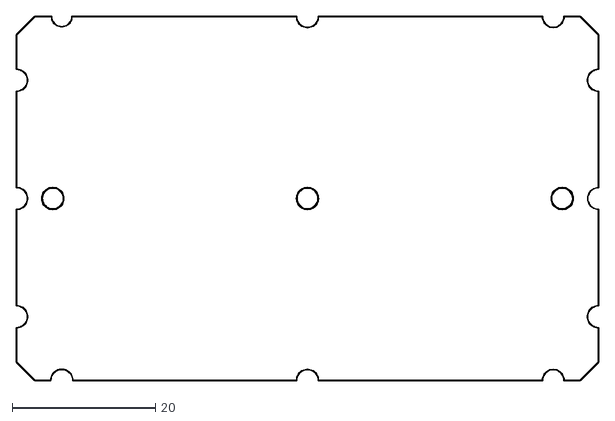
[picture p25: CAD file, 2026-10-20]
docs/reference/digikey_dxf/SOLDERBREAD02_DXF_Outline_in_MilliMeters.dxf
81.3 x 50.9
