traviswolverton/kerbal-controller/(list of files, cad)

Other CAD files:
hardware/cad/console.scad
hardware/cad/test_plate.scad
cad/console_mockup.scad
