traviswolverton/kerbal-controller/(commit log)

2026-10-19 Add to-scale key/pixel pitch comparison drawing
    Three 4x6 MX layouts (19.05 tight, 19.05x28 annunciator rows, 33.3
    cockpit) with one addressable pixel per key, for choosing the control
    panel key pitch.
    Claude-Session: https://claude.ai/code/session_01ASRYtKA1LyxavkNqVidED7
2026-10-19 Add layout B test plate CAD and design decisions
    Parametric OpenSCAD 2x2 test plate for the annunciator-row layout
    (19.05 x 30 mm) with a 10 mm WS2812B pixel pocket above each key,
    varying MX cutout tolerance and diffuser thickness per key. STL
    exports and a decisions log for the settled constraints and open items.
    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
2026-10-19 Lock joystick choice: two SaiDian JH-D400X-R4
    Record the joystick decision, axis mapping, 3.3 V supply note and the
    unknowns (mounting holes, fourth axis) to measure on arrival, plus the
    proposed plain-fader throttle with ghost strip.
    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
2026-10-19 Add JH-D400X-R4 side-view drawing and record its dimensions
    Seller's dimension drawing saved as a reference. Decisions log now
    records tilt range, grip size, body depth, overall height, and that
    the fourth axis is a momentary top button. Mounting flange and hole
    spacing are still unknown (side view only).
    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
2026-10-19 Add full console mockup: 3D renders, 1:1 panel templates, build script
    Parametric OpenSCAD model of the three modules (left: translation stick
    and throttle, centre: 4x6 key bank, toggles, OLEDs and fuel bars, right:
    rotation stick), per-module tilt, seat-view renders, and 1:1 SVG/PDF
    templates generated from the same coordinates.
    The seat view showed the pixels above the keys are hidden behind the
    keycaps at 30 mm row pitch and 12 degree tilt, so the layout is revised
    to 36 mm rows and a 28 degree centre panel. Test plate updated to match.
    Joystick flange and mounting holes remain provisional.
    Claude-Session: https://claude.ai/code/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
2026-10-19 Add parts list, US-only sourcing rule, motorised fader and keycap picks
    - CLAUDE.md: source parts from US retailers only, USD prices, prefer Amazon.com
    - docs/parts-list.md: consolidated parts list with status per part
    - decisions.md: owned blue clicky switches, blank DSA keycaps (Mechkeeb 24-pack),
    Adafruit 5466 motorised fader with L9110H driver and conductive nubbin,
    with mounting dimensions read from the Soundwell drawing and open issues
    - console_mockup.scad: left module uses the motorised fader (two M3 holes,
    body outline, nubbin proxy), ghost strip off via ghost_strip=false.
    Not re-rendered: OpenSCAD is not installed on this machine.
    - mockup README: note that renders and temp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
2026-10-19 Regenerate mockup renders and left template for the motorised fader
    - Refresh the six PNG renders and left-panel-template.svg (fader slot with two
    M3 holes, body outline, nubbin proxy, ghost strip off)
    - Centre and right SVGs left as they were: those modules did not change
    - README: mark left-panel-template-1to1.pdf as stale (no Chromium on this host
    to rebuild it)
2026-10-19 Record the owned buzzer module and its wiring
    - DIYables low-level-trigger buzzer module (B0DHGP95K4), 5 owned
    - Wire VCC from 3.3 V so the on-board PNP switches off cleanly
    - Bench test for passive vs active, measure board and buzzer before CAD
2026-10-19 Record the AITRIP 6-pack as the guarded toggle pick
    - 2-pin SPST ON/OFF with covers, seller-reported 12 mm hole; not yet ordered
    - Four used, two spare; wire to ground and INPUT_PULLUP
    - Check thread length and closed-cover footprint on arrival
2026-10-19 Record the 5 V supply, panel jack and power wiring plan
    - Adafruit 1466 5 V 4 A supply, Adafruit 5607 panel-mount 5.5/2.1 mm jack
    - Pixel budget 3.4 A worst case; cap brightness in firmware
    - Teensy powered from USB only, shared ground, fuse and 1000 uF on the 5 V rail
2026-10-19 Propose DB25 inter-module links
    - One DB25 D-sub per side module, direct-wired to the Teensy in the centre
    - Estimated 16 conductors left, 13 right; fader driver in the left module
    - Female panel-mount jacks and short shielded straight-through cables listed
    - Cross-plug rule so a swapped cable cannot put 5 V on a signal pin
2026-10-19 Propose encoder knobs and record the encoder panel constraint
    - NMOWYBPY 25 x 13 mm aluminium knobs with a D-shaped bore (2 packs for 3 + spare)
    - Bourns PEC11R bushing is only about 5 mm long: keep the panel about 3 mm or
    counterbore it; thread pitch conflict between sources noted
    - Set screw and price still unchecked
2026-10-19 Add draft Teensy pin map and DB25 inter-module pinouts
    - 41 of 42 header pins assigned; pixel data on pin 1, fader PWM on 2 and 3
    - Left DB25 uses 19 conductors, right uses 13
    - Power pins match on both ports and Teensy outputs only land on pins the
    right module leaves open, so a swapped cable cannot cause damage
    - Two SPARE toggles have no pin yet
2026-10-19 Add five-piece console mockup v1
    - New cad/console_mockup_v1.scad: raised 28 degree back strip in three pieces
    plus two 12 degree wings, open middle front, removable 3 mm faceplates
    - Left wing: translation stick, motorised fader, time-warp encoder
    - Right wing: rotation stick, camera and page encoders
    - Strip: 12 nav keys + 2 toggles, OLEDs + fuel bars + buzzer, 12 action-group keys
    + 2 spare toggles
    - Renders in docs/mockup/v1/renders (iso, top, front, side, seat view)
    - v0 mockup untouched; DB25 plan and pin map not yet updated for four cable runs
2026-10-19 Switch the panel jack to the Tugermoola 6-set kit
    - Tugermoola OLA012 (B0D9B7WR23): about 12 mm hole, seller-stated 5 A, 20 AWG,
    150 mm leads on the female jack, $9.99 for 6 sets
    - Replaces Adafruit 5607 (1 inch hole, 30 cm lead, no current rating)
    - Check polarity with a meter before wiring
2026-10-19 Redo pin map and cabling for the five-piece layout
    - Four DB25 ports on the middle strip: left wing (19 conductors), right wing
    (13), left strip (19), right strip (18)
    - One 4 x 6 key matrix split across the strips; one chain of 56 pixels
    (left strip, fuel bars, right strip)
    - Pins laid out so a cable in the wrong port is harmless (checked by script
    for all 16 module and port pairs)
    - Teensy pin 41 is now TOG_SPARE1; the second spare toggle has no pin
    - Parts list: eight DB25 jacks, four cables (2 x 1.5 ft strip, 2 x 3 ft wing)
2026-10-19 Add colour-coded wiring diagrams and a wiring checklist
    - docs/pinout.html: wiring diagrams in the goodnight-device style (dark panel,
    wires in signal colours, power as tags, flags for easy mistakes): the five
    pieces, the Teensy pins, the four DB25 ports, each piece, power
    - docs/tools/gen_pinout.py generates it from one data set
    - docs/wiring-checklist.md: wire colours, per-piece checklist, checks before
    first power-up
    - Fix: the right wing's page-encoder push switch had no DB25 conductor; it is
    now on pin 19, so the right wing has 14 conductors
    - README and pin-map link to the new files
    - Teensy physical pin order is from memory and still to be checked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
2026-10-19 Render the wiring diagrams on GitHub: standalone SVGs and wiring.md
    - GitHub shows .html files as source, so the generator now also writes nine
    standalone SVGs (docs/diagrams/) and docs/wiring.md that embeds them
    - SVGs carry their own colour variables and dark background, checked in Firefox
    - Wrap long diagram footnotes; README, pin-map and checklist link to wiring.md
2026-10-19 Model hollow shells, ballast and feet; add fabrication estimate
    - console_mockup_v1.scad: hollow shells (2.4 mm walls and floor, 3 mm rebate for
    the faceplate), two 6 x 6 x 1/4 in steel plates per wing, four feet per piece,
    cut_x slice and part export options
    - docs/fabrication.md: filament (1.8 kg modelled, about 2.1 kg with ribs),
    weight and sliding, print orientation, what is not designed yet
    - cad/tools/stl_volume.py: volume and PLA mass of the exported shell and
    faceplate STLs
    - Cutaway renders of a wing and a strip piece
2026-10-19 Switch panel on an I2C expander, annunciator, 700 mm layout
    - Left strip (240 mm wide) gets a switch panel: 16 inputs on one MCP23017
    behind it (ABORT, STAGE ARM, big STAGE button, throttle FULL/CUT, MAP, focus
    previous/next, quicksave/quickload, precision, pause, UI hide, 3 spares)
    - Right strip gets a 3 x 3 annunciator (9 pixel windows); high G dropped as
    Simpit has no G-force message
    - Middle strip gets a master 5 V power switch
    - STAGE leaves the key matrix (slot becomes AG9); pixel chain is now 65
    - Teensy pins 18/19 become I2C, pin 41 the expander interrupt, camera encoder
    moves to 26/27; DB25: left strip 21 conductors, right strip 16
    - Cross-plug safety re-checked for all 16 m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
2026-10-19 Add the STAGE key switch and a RESET button to the switch panel
    - A key switch arms the big STAGE button (replaces the STAGE ARM toggle);
    its position is expander input PA1
    - RESET is one of the MX buttons (PB5): the firmware reboots the Teensy so it
    re-handshakes with Simpit
    - Only ABORT stays a guarded toggle, so one of the six in the pack is used
    - Notes the possible meaning of the reference's ENGAGE/DISENGAGE toggle and
    that the two attitude arrow buttons are skipped
    - Mockup, diagrams, pin map, parts list, decisions, checklist and README updated
2026-10-19 Add ENGAGE / DISENGAGE toggle, drop RESET
    - Guarded ENGAGE / DISENGAGE toggle on the switch panel (expander PB5): a
    controls-live interlock. Disengaged, the firmware sends zero rotation and
    translation and stops sending throttle; the annunciator's CONTROLS window
    lights while engaged
    - RESET dropped; PB5 now ENGAGE, PB6 and PB7 stay spare
    - Small-button grid is 3 x 4 (10 used, 2 spare) to make room for the third
    guarded toggle, the STAGE key switch and the big STAGE button
    - Mockup, diagrams, pin map, parts list (2 guarded toggles), decisions,
    checklist and README updated
2026-10-19 Add a Digi-Key parts selection tool and make Digi-Key the primary source
    - docs/tools/dk.py: search, part details, shortlist and live price/stock/status
    check against the Digi-Key Product Information V4 API (client-credentials
    OAuth, standard library only); writes docs/digikey-bom.md on request
    - Offline tests with a fake API (docs/tools/test_dk.py); not yet run against
    the live API because that needs the owner's credentials
    - docs/tools/README.md: setup and use; .gitignore keeps .env out of the repo
    - CLAUDE.md and README: Digi-Key first, Amazon.com as the fallback
2026-10-19 Add Mouser as a second parts source; one tool for both
    - parts.py: search, part, add and check across Digi-Key and Mouser, merged
    results, one source failing does not hide the other; shortlist in
    docs/parts-shortlist.json, BOM in docs/parts-bom.md
    - mouser.py backend, tested live (search, part details, shortlist, check);
    digikey.py backend unchanged in behaviour, still untested live
    - common.py shared helpers; dk.py and test_dk.py renamed to digikey.py and
    test_parts.py (16 offline tests)
    - .env.example lists the keys; tools README, CLAUDE.md and README updated
2026-10-19 Pick the open parts and consolidate sourcing on Digi-Key
    - Digi-Key order of 28 lines, $225.78, all checked live: in stock, minimum
    order 1, shortlist in docs/parts-shortlist.json and docs/parts-bom.md
    - Open parts picked: STAGE key switch (E-Switch KO133A801, 12 mm cutout), big
    STAGE button (Adafruit 3489, 30 mm), master switch (E-Switch ST141D00)
    - Moved to Digi-Key: Teensy 4.1 (SparkFun 20360), Mean Well GST25A05-P1J
    adapter plus mains cord, Tensility panel jack, Adafruit fader, driver and
    nubbin, Bourns encoders, MCP23017 on perfboard, DB25 jacks (male outer,
    female middle) and 1 m female-to-male cables, USB panel extension, passives
    - Amazon stays for joysticks, owned switches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
2026-10-19 Model the DB25 jacks and route the inter-piece cables outside
    - Cutouts from the ITT Cannon ZD datasheet (rear mount): 42.52 x 11.40 mm with
    two 3.05 mm holes 47.04 mm apart (modelled 3.2 mm), flange 53.09 mm
    - Middle strip: four female jacks on the back wall in two rows; each outer
    strip: one male jack on its back wall; each wing: one male jack on its outer
    end wall. Jacks mount from inside with the body 11 mm proud
    - Every cable now runs outside, behind the console (about 0.6 m for a wing),
    so no pass-through holes are needed; docs, diagrams and checklist updated
    - New rear render and refreshed iso, top and wing cutaway
    - DC jack, fuse holder and USB cutouts are still open
    Co-Auth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
2026-10-19 Add provisional rear cutouts and electronics build notes
    - Orange placeholders on the middle strip's back wall for the DC jack (11 mm),
    fuse holder (12.5 mm) and USB micro-B (15 x 8 mm slot): sizes not verified,
    they only hold the place until the parts are measured
    - docs/electronics-build.md: rough perfboard plan per piece with candidate
    Digi-Key parts (about $95), not yet in the shortlist
    - decisions, fabrication notes and README updated; rear render refreshed
2026-10-19 Add a combined budget page and the perfboard parts to the shortlist
    - parts.py budget: totals the shortlist plus a hand-kept Amazon list
    (docs/amazon-items.json); owned items listed but not counted, unpriced
    Amazon items named rather than guessed; writes docs/budget.md
    - parts.py amazon-price records a price seen on Amazon
    - Perfboards, terminal blocks, headers, wire and heat shrink added to the
    shortlist: Digi-Key now 36 lines, $322.72
    - Total so far $360.30 with 5 Amazon items still unpriced
    - Tools README, parts list, electronics notes and README updated
2026-10-19 Resize the console around a 12.2 in 60% keyboard
    - Strips 245 mm wide (735 mm in all), wings 195 mm, so the open middle is
    345 mm wide and 176 mm deep: about 17 mm each side of a 310 mm keyboard
    - Wing contents re-spaced for 195 mm: left wing fader u=25, stick u=108,
    encoder u=168; right wing stick u=75, encoders u=150; ballast plates still fit
    - Middle-strip jacks and provisional cutouts re-centred
    - A 310 x 110 mm keyboard is shown in the gap in the renders
    - Decisions record the keyboard as a design constraint, with what to revisit if it
    changes; filament now 1.77 kg modelled, about 2.0 kg with ribs
    - All v1 renders regenerated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
2026-10-19 Add a control map
    docs/controls.md lists every control panel by panel: what it does, which
    Simpit mechanism or key it uses, its expander pin, and whether the function
    is decided, proposed or still open. Linked from the README.
2026-10-19 Decide the grip buttons: SAS toggle right, fine control left
    - Right stick grip button toggles SAS
    - Left stick grip button, while held, scales that stick's X, Y and twist to
    about 25% in firmware (docking)
    - Both are direct Teensy inputs (pins 5 and 9)
    - Control map and decisions updated; the stale "plain fader or motorised"
    open item removed (motorised was decided)
2026-10-20 Guard the master power switch
    - The master power switch is now a guarded AITRIP toggle (a third from the
    6-pack, three left over) instead of the plain E-Switch ST141D00, so a bump
    cannot kill the lights; the E-Switch line is dropped from the shortlist
    - Mockup shows the cover; controls, decisions, parts list and README updated
    - Digi-Key re-checked live today: 35 lines, $316.20, no flags; total so far
    $353.78 with 5 Amazon items unpriced
2026-10-20 Add a to-do list compiled from the design session
    docs/todo.md groups what is left: before ordering, bench tests when the parts
    arrive, printing, CAD, open decisions, firmware, build and bring-up, and
    housekeeping. Linked from the README.
2026-10-20 Move the encoder knobs to Digi-Key and drop the dead Amazon entries
    Knobs: CLIFF KMK25 silver, 25 x 15 mm, 6 mm D shaft (4654-FC7254-ND, $4.90,
    3 needed). The NMOWYBPY listing and both steel plate listings were dead links,
    so those entries are removed; the ballast steel is now to be bought locally.
    Records the three Amazon prices entered by hand and regenerates the budget
    ($436.43 so far, steel not included).
2026-10-20 Swap the small perfboards to a pad-per-hole board
    The DigiKey SOLDERBREAD-02 is breadboard-style (5-hole pads), which would short
    parts placed in the same pad. The four expander, wing and bus boards are now the
    DFRobot FIT0203 (78 x 58 mm, pad per hole). The middle strip's SparkFun 12070
    has the same issue and is flagged open in electronics-build.md.
2026-10-20 Add the DigiKey SOLDERBREAD-02 outline DXF
    Manufacturer outline of the perfboard (81.33 x 50.85 mm, three 3.1 mm mounting
    holes), kept for planning standoffs. Outline only: no hole grid.
2026-10-20 Use the datasheet cutouts for the DC jack and fuse holder
    DC jack (Tensility 54-00151): 10.9 mm round with two 9.8 mm flats, panel 1.5-4.5 mm.
    Fuse holder (Wurth 952005000010000): 13 mm round with a 1.8 mm key out to 14 mm,
    panel 0.8-2.8 mm. Both fit the 2.4 mm back wall. The USB extension's datasheet
    gives no cutout, so that one stays a provisional placeholder.
2026-10-20 Organize the docs into folders and archive the v0 mockup
    docs/ now has design/, wiring/, sourcing/, reference/ and archive/. The generated
    wiring files, diagrams and the sourcing files moved with their generators
    updated (gen_pinout.py, parts.py). pinout.html and index.html stay at the docs
    root so the Pages URL still works. The three-module mockup (renders, templates,
    scad and build script) is archived, and docs/mockup/ has a new README for the
    current five-piece renders. All relative links re-checked.
2026-10-20 Split the repo into hardware, firmware, docs and tools
    hardware/ holds cad, electronics (pinmap.json, wiring), sourcing, mockup renders
    and reference files. firmware/ksp is a PlatformIO project stub for the Teensy 4.1.
    docs/ keeps the decisions, control map, to-do, the firmware outline and the Pages
    site. tools/ holds the scripts.
    The pin data moves into hardware/electronics/pinmap.json. tools/gen_wiring.py
    (renamed from gen_pinout.py) now also writes firmware/ksp/include/pins.h, and
    new tests check the pin data and that pins.h is current.
    Removes the v0 mockup and its archives, renames console_mockup_v1.scad to
    console.scad and drops the v1- prefix from the renders. Links re-checked.
    Co-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
2026-10-20 Use Mavee vest plates as the wing ballast
    Two packs of eight plates (150 x 25 x 7.1 mm, 0.44 lb each): 8 per wing in two
    layers of 4, about 3.2 kg, with room for 12 per wing if a third pack is needed.
    CAD stack, sourcing, budget (now $486.05), fabrication notes and to-do updated.
    The listing's ASIN is not resolved yet, so the entry carries the short link.
2026-10-20 Switch the displays to two DFRobot DFR0669 3.5" IPS TFTs
    Replaces the two Waveshare OLEDs with two DFR0669 (Digi-Key 1738-DFR0669-ND,
    480x320 IPS, ILI9488, SPI). The pin data renames OLED_* to TFT_* with the same
    pins; the displays run from 3V3 with BL tied to VCC. The middle strip is re-laid
    out: two 75 x 50 mm windows side by side, fuel bars as four horizontal rows of 8,
    buzzer and master switch to the right. Docs, diagrams, pins.h, sourcing and
    budget updated ($497.87 so far). Display area offset and logic level still to be
    checked on the real board.
2026-10-21 Drop the heat shrink from the order
    Already owned. The two hookup wire kits stay. Digi-Key total is now $370.39 and
    the overall total $487.92.
2026-10-21 Merge the sourcing docs into one generated parts.md
    parts-list.md, budget.md and parts-bom.md all listed the same parts. They are now
    one generated file, hardware/sourcing/parts.md (totals, linked part numbers with
    notes and stock, Amazon items, owned items). The hand-written notes moved into
    parts-shortlist.json and amazon-items.json. tools/parts.py budget --md writes it
    (--live re-checks first); check no longer writes a bom file; add gains --note.
    References and a report test updated.
2026-10-21 Add DB25 soldering notes and double the jack order
    The wiring checklist gains a section on soldering the DB25 solder-cup jacks (pin
    counts, thin stranded wire, pre-tinning, alternating pins, continuity checks, a
    crimp fallback). The order doubles the ZDB25S and ZDB25P jacks to 8 each so there
    are spares to practise on. Parts total is now $517.56.
2026-10-21 Add the DB25 solder-order diagram and the Phoenix cable datasheet findings
    New db25-solder diagram (solder-side view of all eight jacks, coloured by solder
    order, ground and 5 V pins marked for two wires) generated by tools/gen_wiring.py,
    plus the per-jack order table in the wiring checklist. The Phoenix 1656291
    datasheet (shielded, stranded, rated 1 A, no gauge given) is noted in the parts
    list, the checklist (current limit, shield grounding) and the to-do.
2026-10-21 Make the repo beginner-friendly and save the datasheets
    Docs: rewrite the README as a front door with a status board and reading path,
    add a landing page, how-it-works, glossary, journey, why-not, gallery,
    getting-started and a first power-up guide, and give every doc a four-line
    header with shared status words. Reorganise the to-do around blockers.
    Tooling: add a Makefile, a check that generated files are not stale, and a CI
    workflow that runs the tests and that check. Generated files (wiring docs,
    pinout page, parts.md) now carry the same header, set in their generators, and
    parts.md opens with a shopping list at a glance.
    Also commits earlier work in progress: shortlist updates, parts.p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
2026-10-21 Link to the datasheets instead of saving copies
    Removes the saved datasheet PDFs and links every part in parts.md to the maker's
    datasheet page. Fills in the missing links for the Teensy, the fader nubbin and
    the SN74AHCT125 (TI's direct PDF address). The PDFs remain in earlier history.
2026-10-21 Regenerate the renders from the current model
    The renders now show the two TFT windows, the horizontal fuel bars and the
    datasheet cutouts for the DC jack and fuse holder; only the USB extension is
    still an orange placeholder. The camera settings move into hardware/cad/render.sh
    (make renders), docs/img is refreshed with make site, and the mockup README no
    longer says the pictures are out of date.
2026-10-22 Record why a 24 V supply was not chosen
    decisions.md notes the 24 V to 5 V option (benefit, cost, and when to revisit; 12 V
    is the next step for a weak fader) and why-not.md has the plain-language answer.
    Also fixes a stale line: the DC jack's panel cutout is now taken from its datasheet.
